AVeryHappyTeddyBear/AutoRubber/README.md

# AutoRubber
A 3D printable automatic rubber band gun design

Just read the Instructions pdf

All STL files are in the STL folder and the all of the SolidWorks files are in the SolidWorks folder
