AVeryHappyTeddyBear/AutoRubber/SolidWorks/Assembly.SLDASM

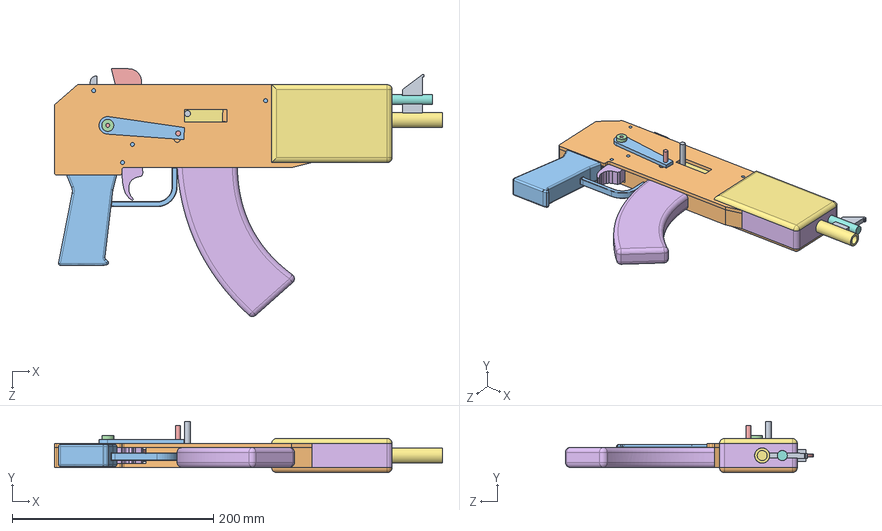
[picture p1: CAD file, 2020-06-26]
SolidWorks/Assembly.SLDASM
386.0 x 51.0 x 246.9 mm
wheel
FrameA
pinA x 4
toggle
release
trigger
Reciever
reciever_swingybit
bolt
FrameB
Lever
pin_fitting
pinD
FrameC
BarrelA
BarrelB
sight
SidingB
grip
pinC x 2
pinB
mag
SidingA
