AVeryHappyTeddyBear/AutoRubber/SolidWorks/wheel.SLDPRT

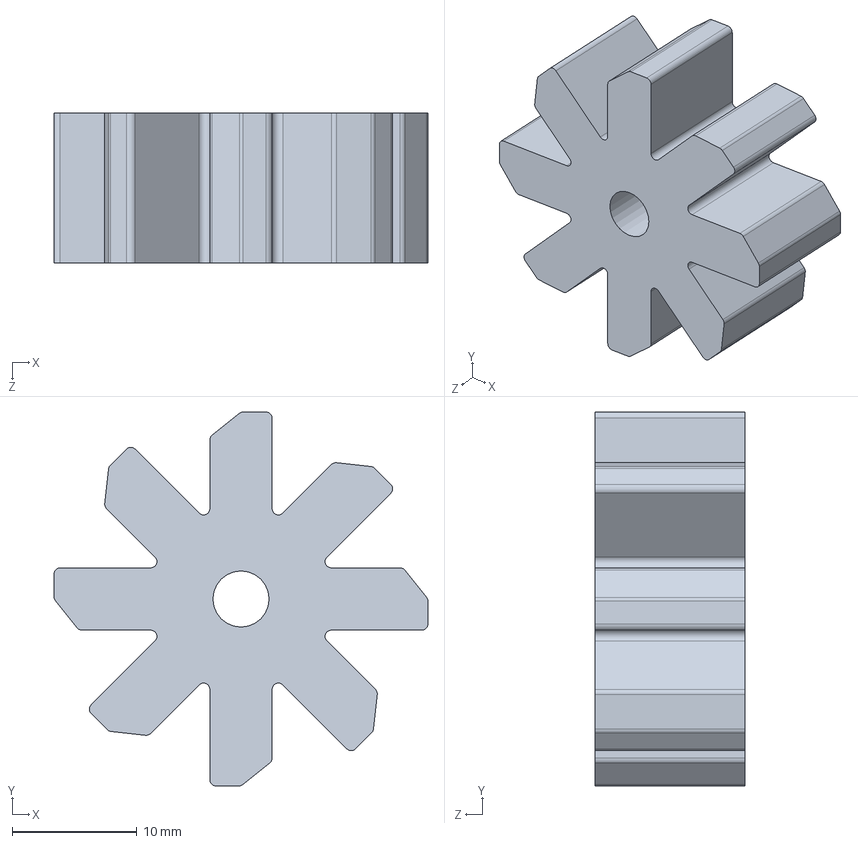
[picture p2: CAD file, 2020-07-12]
SolidWorks/wheel.SLDPRT
30.0 x 30.0 x 12.0 mm
