AVeryHappyTeddyBear/AutoRubber/SolidWorks/toggle.SLDPRT

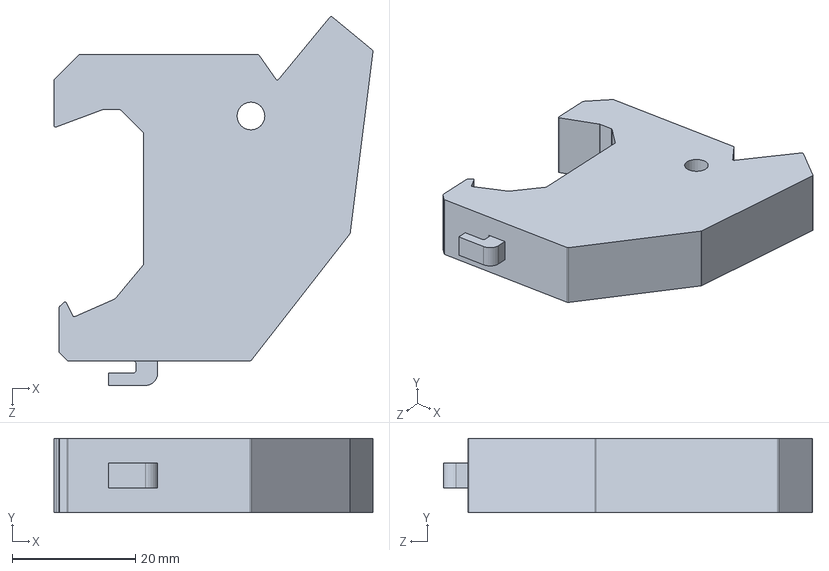
[picture p3: CAD file, 2020-07-12]
SolidWorks/toggle.SLDPRT
51.7 x 12.0 x 59.8 mm
