AVeryHappyTeddyBear/AutoRubber/SolidWorks/BarrelA.SLDPRT

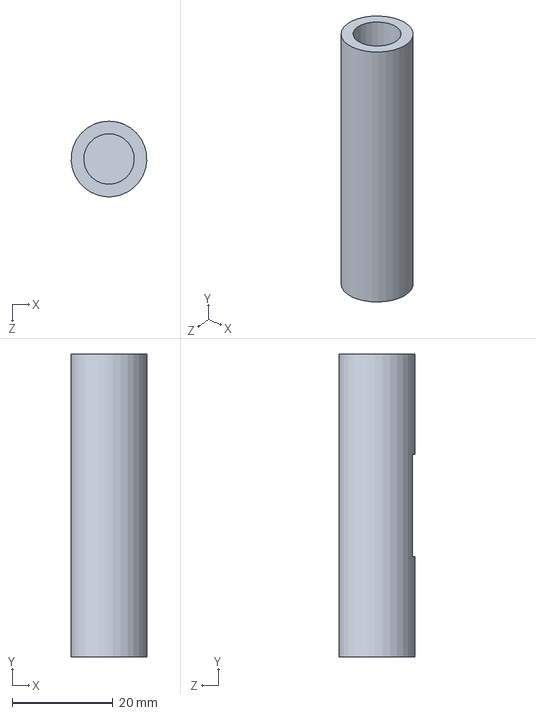
[picture p4: CAD file, 2020-06-26]
SolidWorks/BarrelA.SLDPRT
15.0 x 60.0 x 15.0 mm
