AVeryHappyTeddyBear/AutoRubber/SolidWorks/pinB.SLDPRT

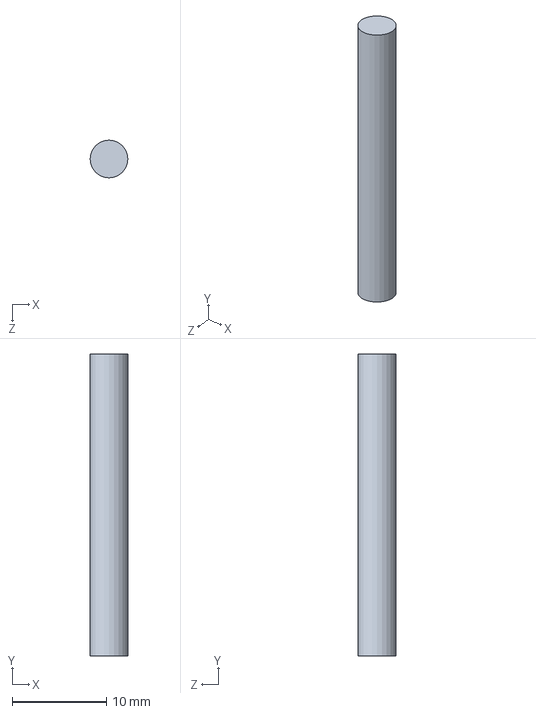
[picture p5: CAD file, 2020-06-26]
SolidWorks/pinB.SLDPRT
4.00 x 32.0 x 4.00 mm
