AVeryHappyTeddyBear/AutoRubber/SolidWorks/trigger.SLDPRT

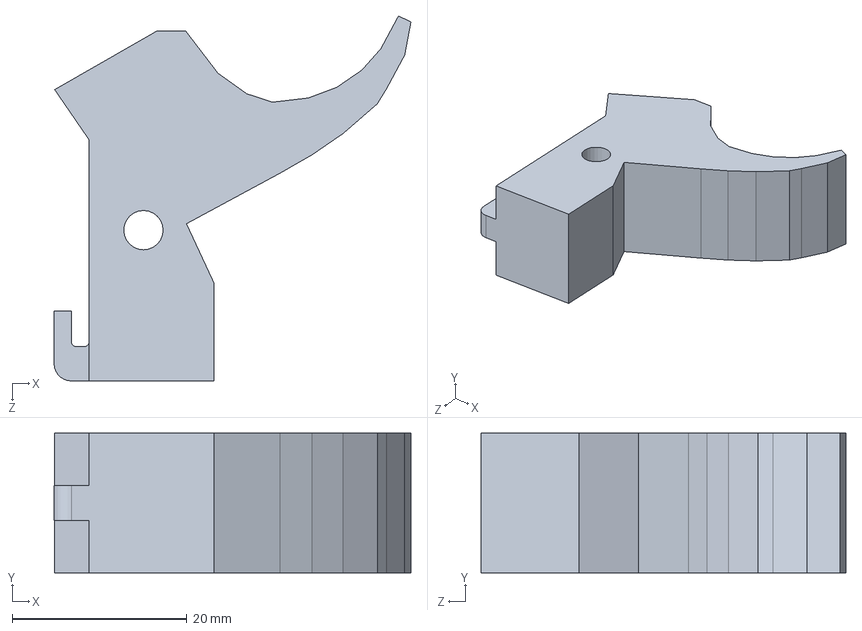
[picture p6: CAD file, 2020-06-26]
SolidWorks/trigger.SLDPRT
40.8 x 16.0 x 41.8 mm
