AVeryHappyTeddyBear/AutoRubber/SolidWorks/FrameC.SLDPRT

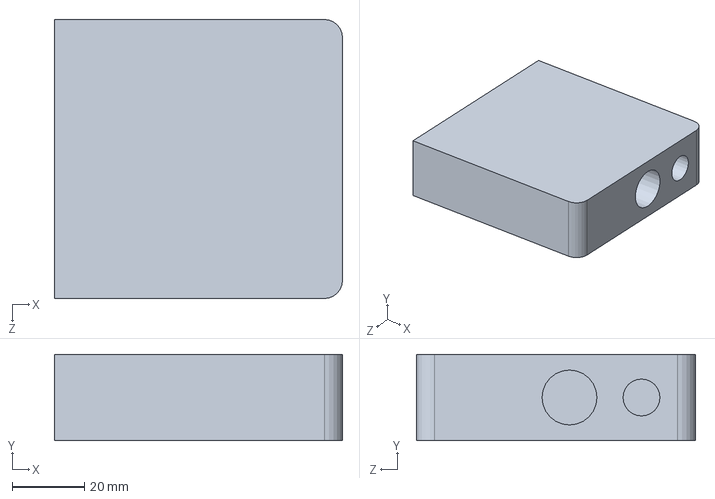
[picture p7: CAD file, 2020-06-26]
SolidWorks/FrameC.SLDPRT
80.0 x 24.0 x 77.5 mm
