AVeryHappyTeddyBear/AutoRubber/SolidWorks/pinD.SLDPRT

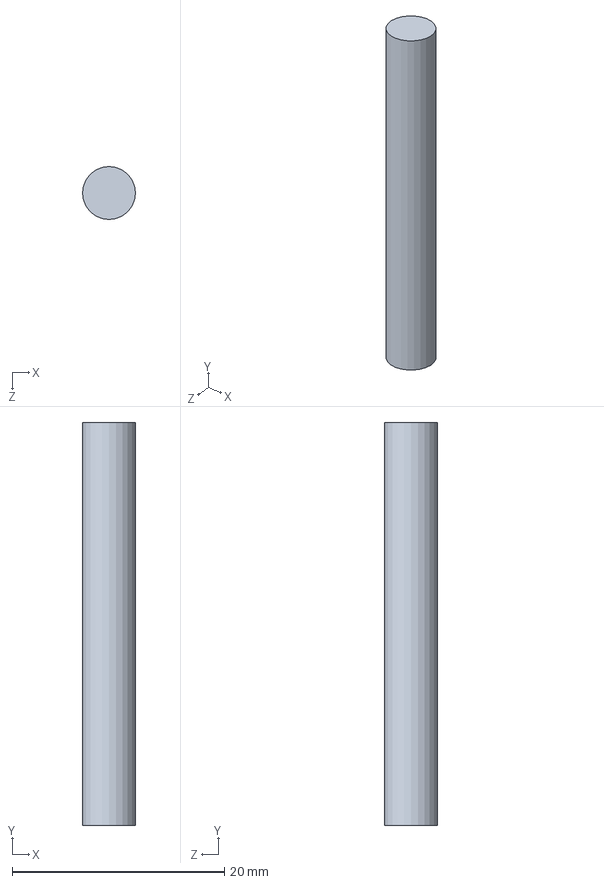
[picture p8: CAD file, 2020-06-26]
SolidWorks/pinD.SLDPRT
5.00 x 38.0 x 5.00 mm
