AVeryHappyTeddyBear/AutoRubber/SolidWorks/FrameB.SLDPRT

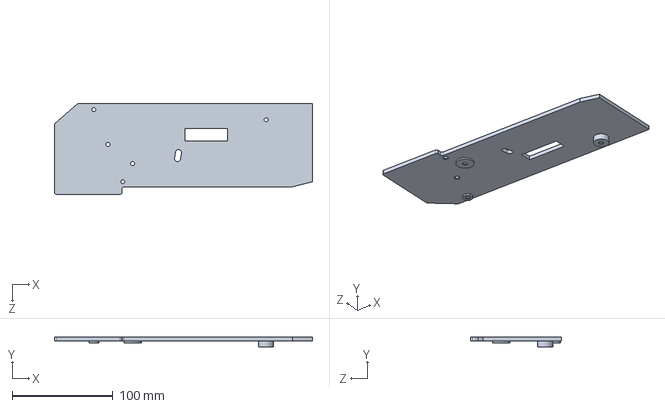
[picture p9: CAD file, 2020-06-26]
SolidWorks/FrameB.SLDPRT
256.0 x 10.0 x 90.0 mm
