AVeryHappyTeddyBear/AutoRubber/SolidWorks/grip.SLDPRT

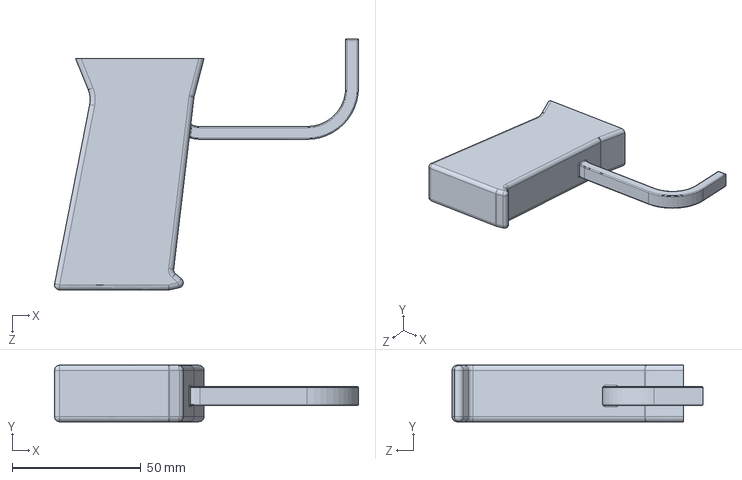
[picture p10: CAD file, 2020-06-26]
SolidWorks/grip.SLDPRT
118.1 x 22.0 x 97.5 mm
