AVeryHappyTeddyBear/AutoRubber/SolidWorks/SidingB.SLDPRT

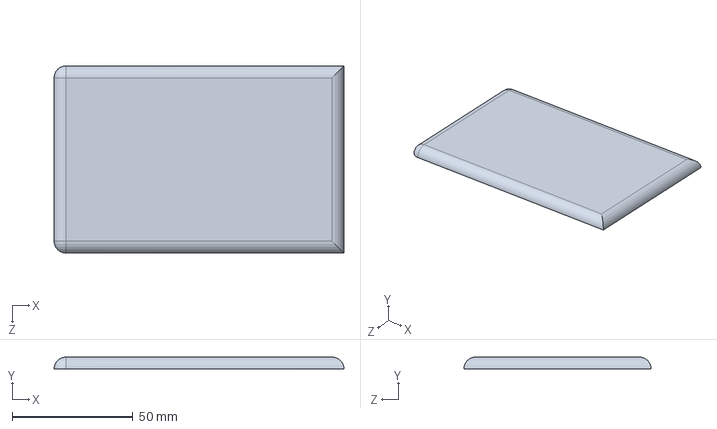
[picture p11: CAD file, 2020-06-26]
SolidWorks/SidingB.SLDPRT
120.0 x 5.00 x 77.5 mm
