AVeryHappyTeddyBear/AutoRubber/SolidWorks/BarrelB.SLDPRT

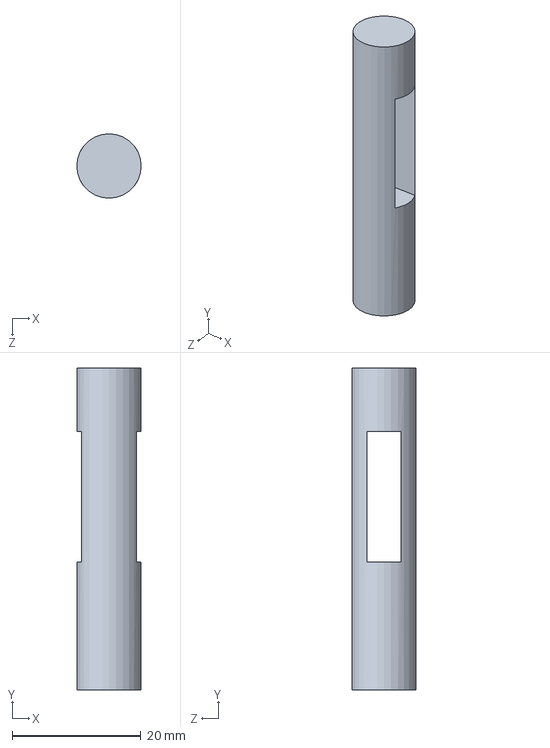
[picture p12: CAD file, 2020-06-26]
SolidWorks/BarrelB.SLDPRT
10.0 x 50.0 x 10.0 mm
