AVeryHappyTeddyBear/AutoRubber/SolidWorks/sight.SLDPRT

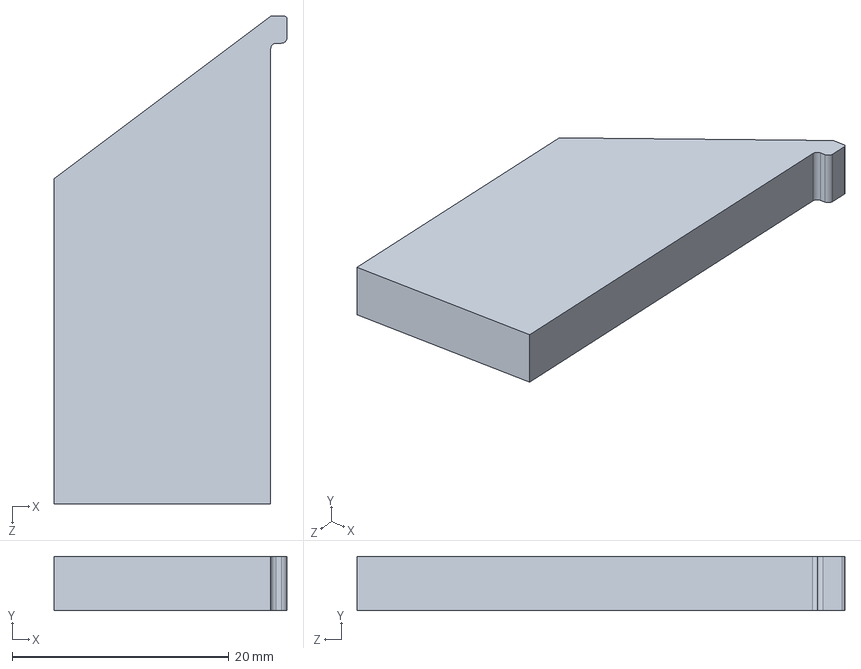
[picture p13: CAD file, 2020-06-26]
SolidWorks/sight.SLDPRT
21.5 x 5.00 x 45.0 mm
