AVeryHappyTeddyBear/AutoRubber/SolidWorks/Reciever.SLDPRT

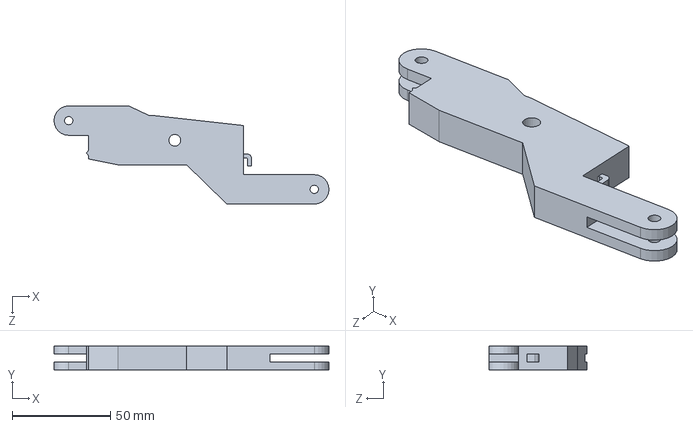
[picture p14: CAD file, 2020-06-26]
SolidWorks/Reciever.SLDPRT
140.0 x 12.0 x 50.0 mm
