AVeryHappyTeddyBear/AutoRubber/SolidWorks/mag.SLDPRT

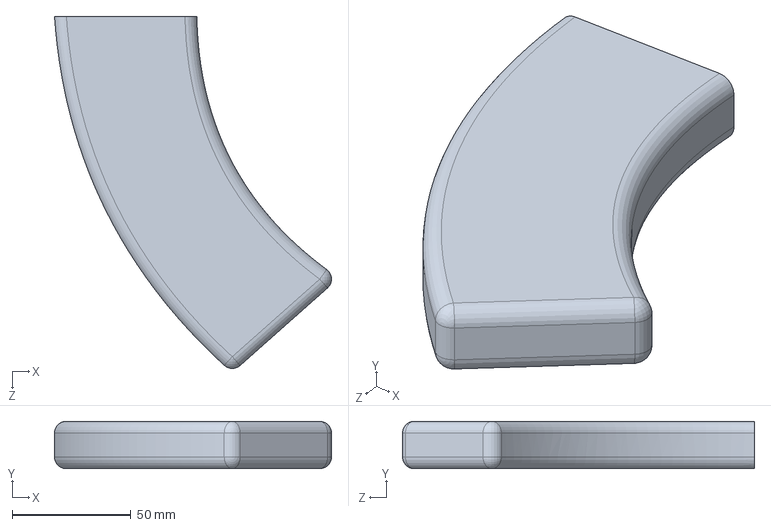
[picture p15: CAD file, 2020-06-26]
SolidWorks/mag.SLDPRT
116.7 x 20.0 x 148.3 mm
