AVeryHappyTeddyBear/AutoRubber/SolidWorks/Lever.SLDPRT

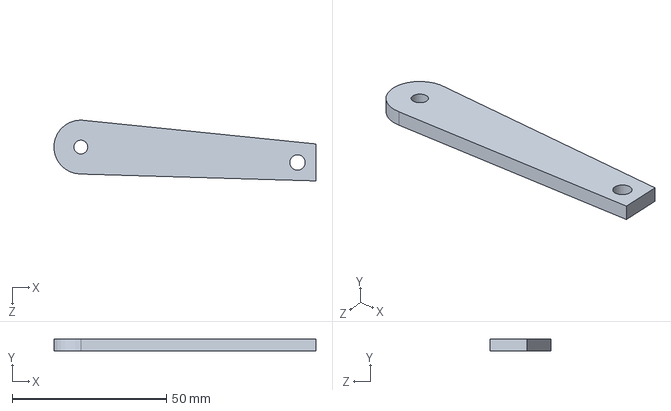
[picture p16: CAD file, 2020-06-26]
SolidWorks/Lever.SLDPRT
85.0 x 4.00 x 19.8 mm
