AVeryHappyTeddyBear/AutoRubber/SolidWorks/pinA.SLDPRT

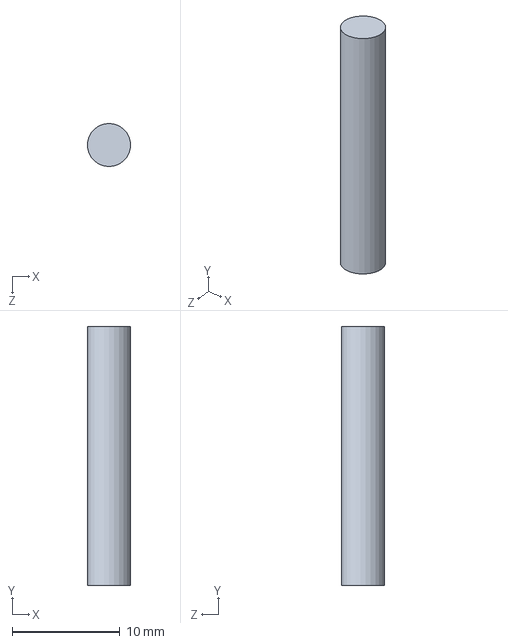
[picture p17: CAD file, 2020-06-26]
SolidWorks/pinA.SLDPRT
3.97 x 24.0 x 4.00 mm
