AVeryHappyTeddyBear/AutoRubber/SolidWorks/pinC.SLDPRT

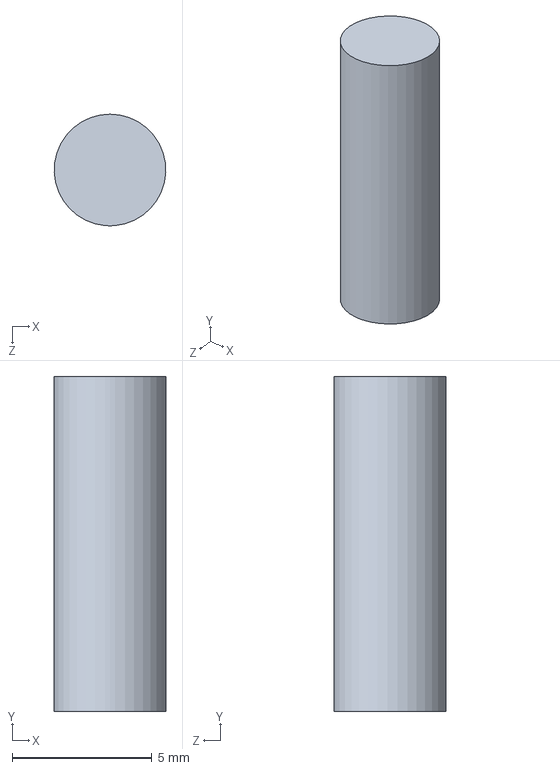
[picture p18: CAD file, 2020-06-26]
SolidWorks/pinC.SLDPRT
4.00 x 12.0 x 4.00 mm
