AVeryHappyTeddyBear/AutoRubber/SolidWorks/FrameA.SLDPRT

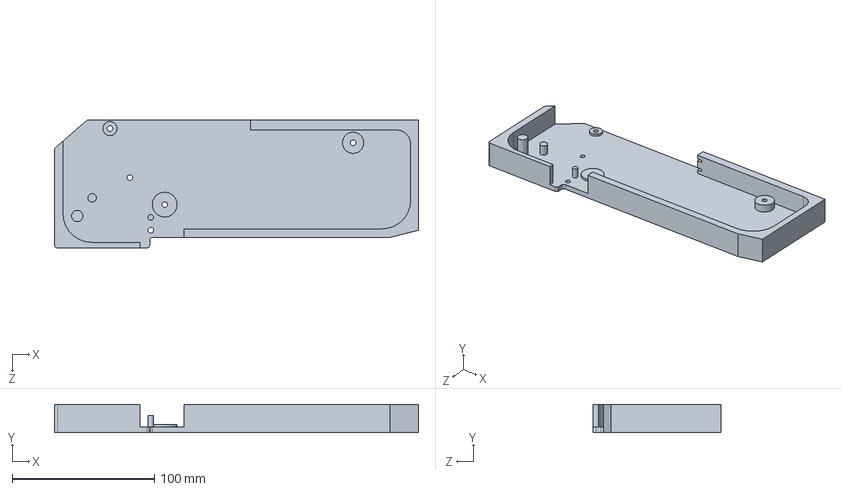
[picture p19: CAD file, 2020-06-26]
SolidWorks/FrameA.SLDPRT
256.0 x 20.0 x 90.0 mm
