AVeryHappyTeddyBear/AutoRubber/SolidWorks/reciever_swingybit.SLDPRT

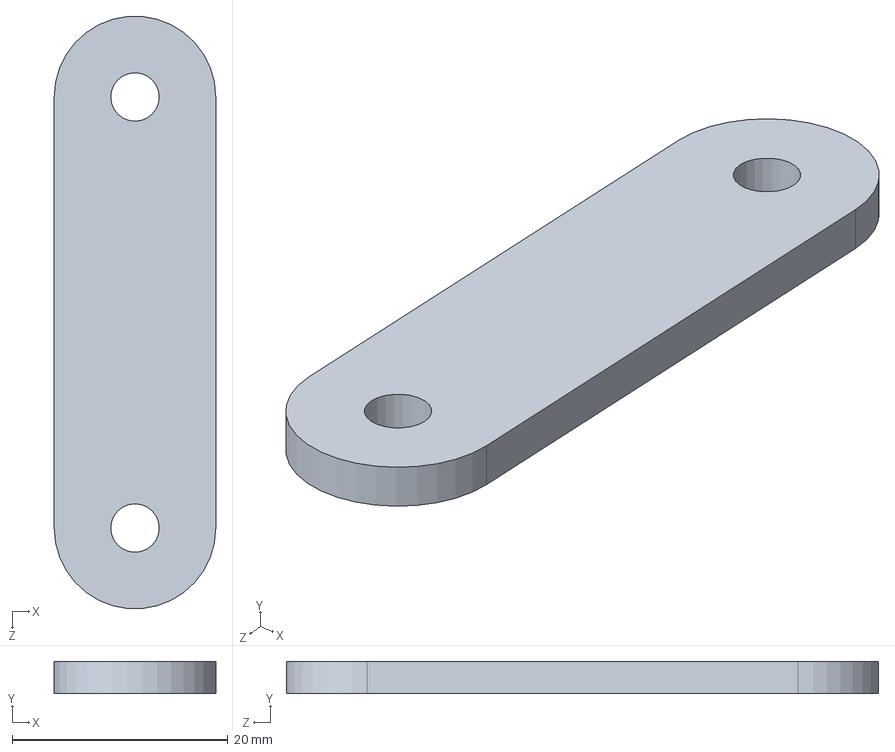
[picture p20: CAD file, 2020-06-26]
SolidWorks/reciever_swingybit.SLDPRT
15.0 x 3.00 x 54.9 mm
