AVeryHappyTeddyBear/AutoRubber/SolidWorks/release.SLDPRT

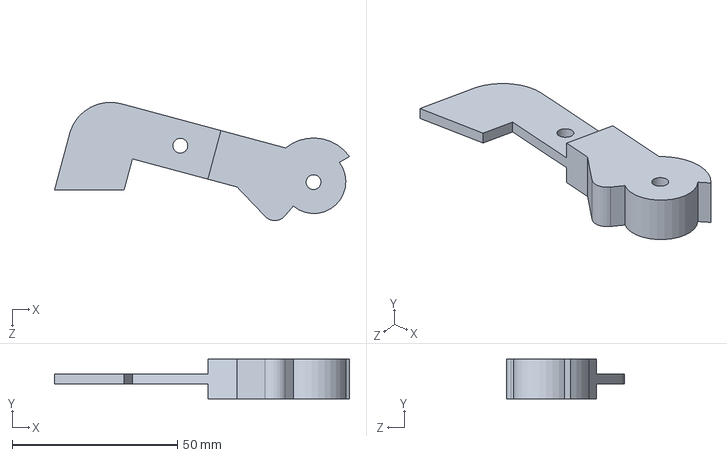
[picture p21: CAD file, 2020-06-26]
SolidWorks/release.SLDPRT
89.4 x 12.0 x 35.8 mm
