AVeryHappyTeddyBear/AutoRubber/SolidWorks/pin_fitting.SLDPRT

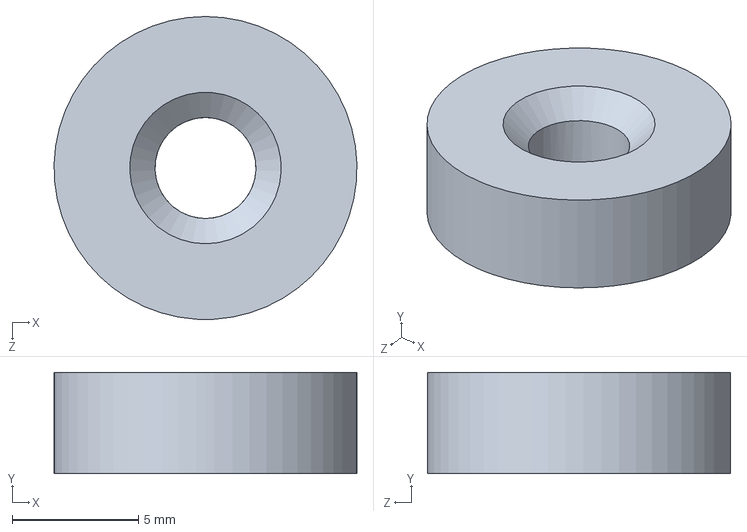
[picture p22: CAD file, 2020-06-26]
SolidWorks/pin_fitting.SLDPRT
12.0 x 4.00 x 12.0 mm
