AVeryHappyTeddyBear/AutoRubber/(list of files, cad)

Other CAD files:
SolidWorks/SidingA.SLDPRT
STL/BarrelA.STL
STL/BarrelB.STL
STL/FrameA.STL
STL/FrameB.STL
STL/FrameC.STL
STL/Lever.STL
STL/Reciever.STL
STL/SidingA.STL
STL/SidingB.STL
STL/bolt.STL
STL/grip.STL
STL/mag.STL
STL/pinA.STL
STL/pinB.STL
STL/pinC.STL
STL/pinD.STL
STL/pin_fitting.STL
STL/reciever_swingybit.STL
STL/release.STL
STL/sight.STL
STL/toggle.STL
STL/trigger.STL
STL/wheel.STL
SolidWorks/bolt.SLDPRT
