AVeryHappyTeddyBear/AutoRubber/(commit log)

2020-06-26 Delete STL.zip
    Moved the STL's to a folder in the repository so they can be more easily updated in the future
2020-06-26 SolidWorks Files
    [Assembly.SLDASM, BarrelA.SLDPRT, BarrelB.SLDPRT, FrameA.SLDPRT, FrameB.SLDPRT, FrameC.SLDPRT, Lever.SLDPRT, Reciever.SLDPRT]
2020-06-26 Delete Assembly.zip
    Replacing the zip file with a folder in the repository
2020-07-12 Delete toggle.STL
    Replacing with v1.5 toggle
    [toggle.STL]
2020-07-12 Delete wheel.STL
    Replacing with v1.5 wheel
    [wheel.STL]
2020-07-12 Add files via upload
    new parts
    [toggle.STL, wheel.STL]
2020-07-12 Add files via upload
    new v1.5 files
    [toggle.SLDPRT, wheel.SLDPRT]
